Epicguru/Midship-Runabout-Rusefi-PNP-KiCAD/Original Source/Readme.md

These are the original Gerber, BOM and CPL files that were used to make the KiCAD version.
Also included is the original tune.
These will not be updated even if the upstream is updated - they are just for reference.

My version of the board has a slightly different pinout, it has extra inputs as well, so the tune is different.
