Epicguru/Midship-Runabout-Rusefi-PNP-KiCAD/Original Source/MRRpinout.png

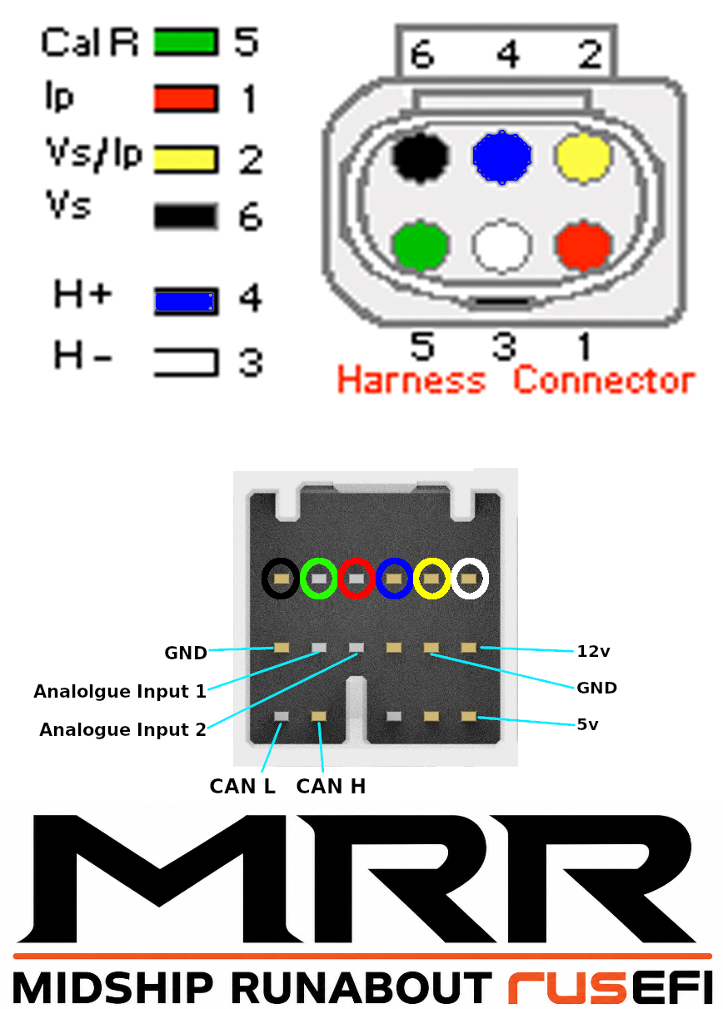
Original Source/MRRpinout.png
