Epicguru/Midship-Runabout-Rusefi-PNP-KiCAD/Original Source/Schematic_PnP-ECU2-Rev2_2026-10-17.png

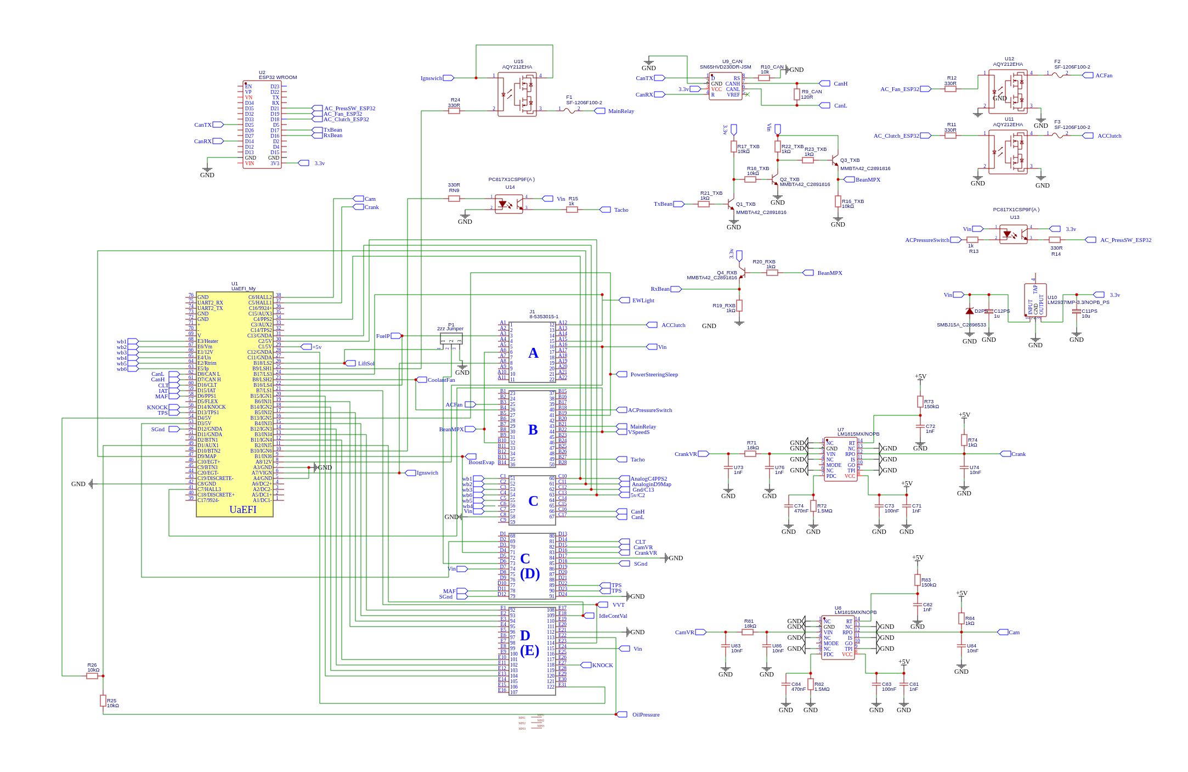
Original Source/Schematic_PnP-ECU2-Rev2_2026-10-17.png
