Epicguru/Midship-Runabout-Rusefi-PNP-KiCAD/KiCAD Source/MRR_PnP_ECU2.kicad_pcb

## KiCad design KiCAD Source/MRR_PnP_ECU2.kicad_pcb (2026-10-23)

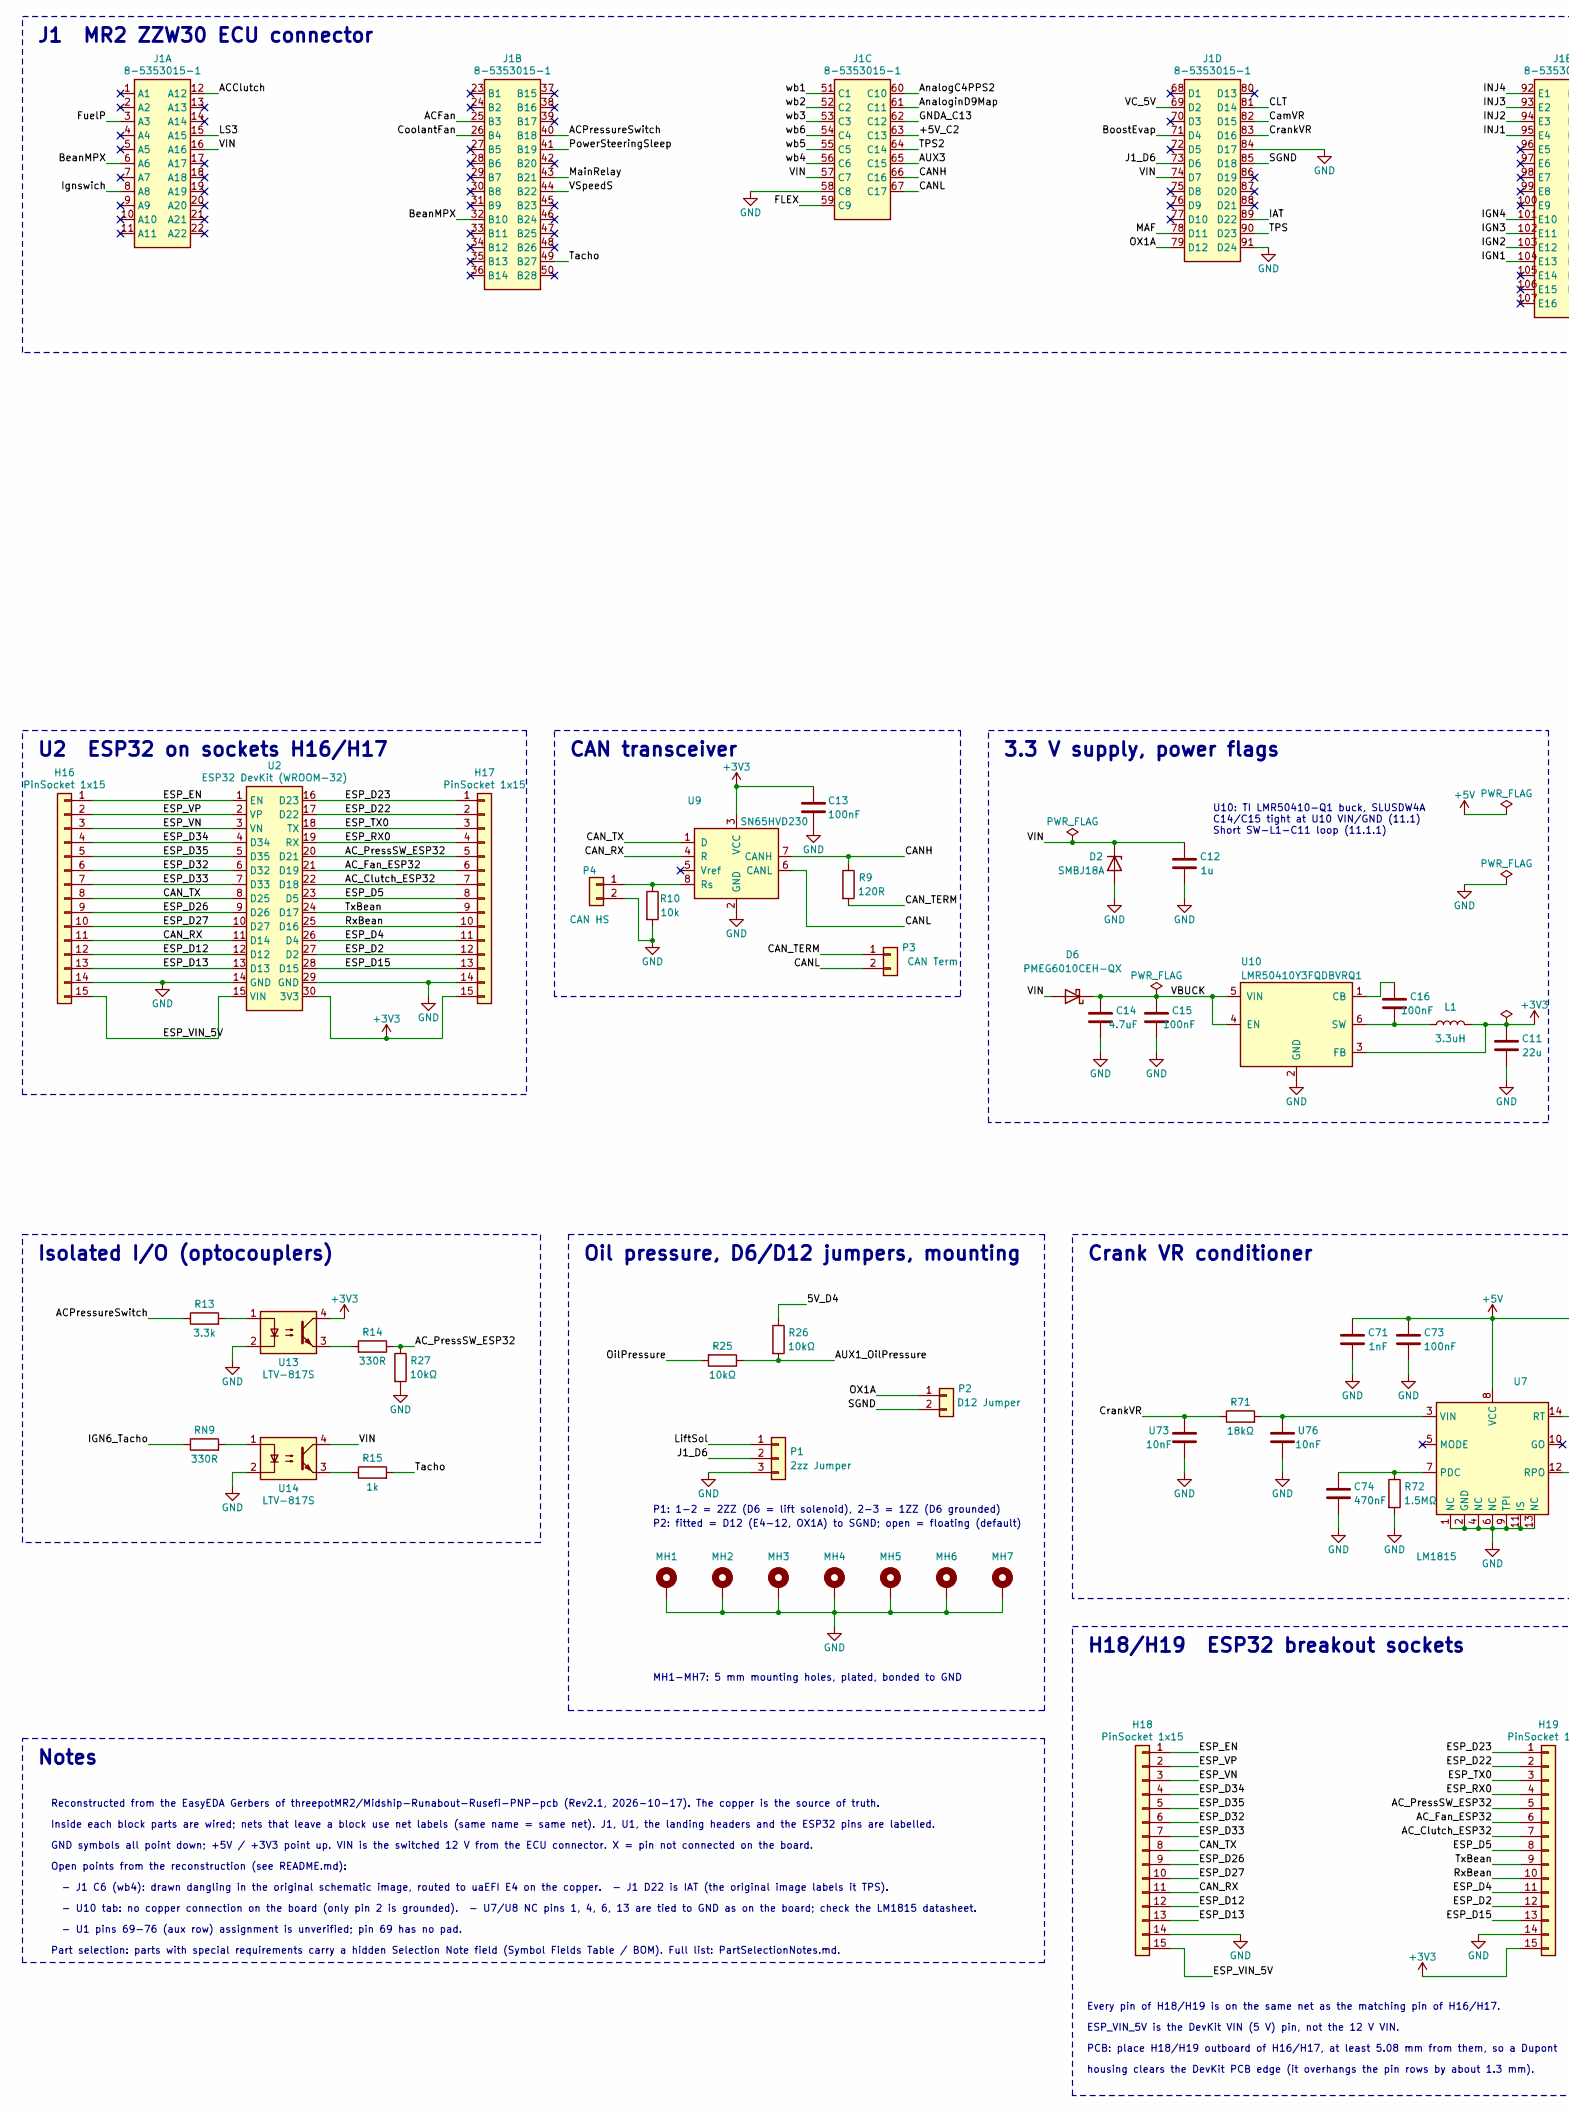
[picture p11: schematic MRR_PnP_ECU2.kicad_sch, MRR PnP-ECU2 Rev2.1 - uaEFI carrier, MR2 ZZW30, part in row 1, column 1]

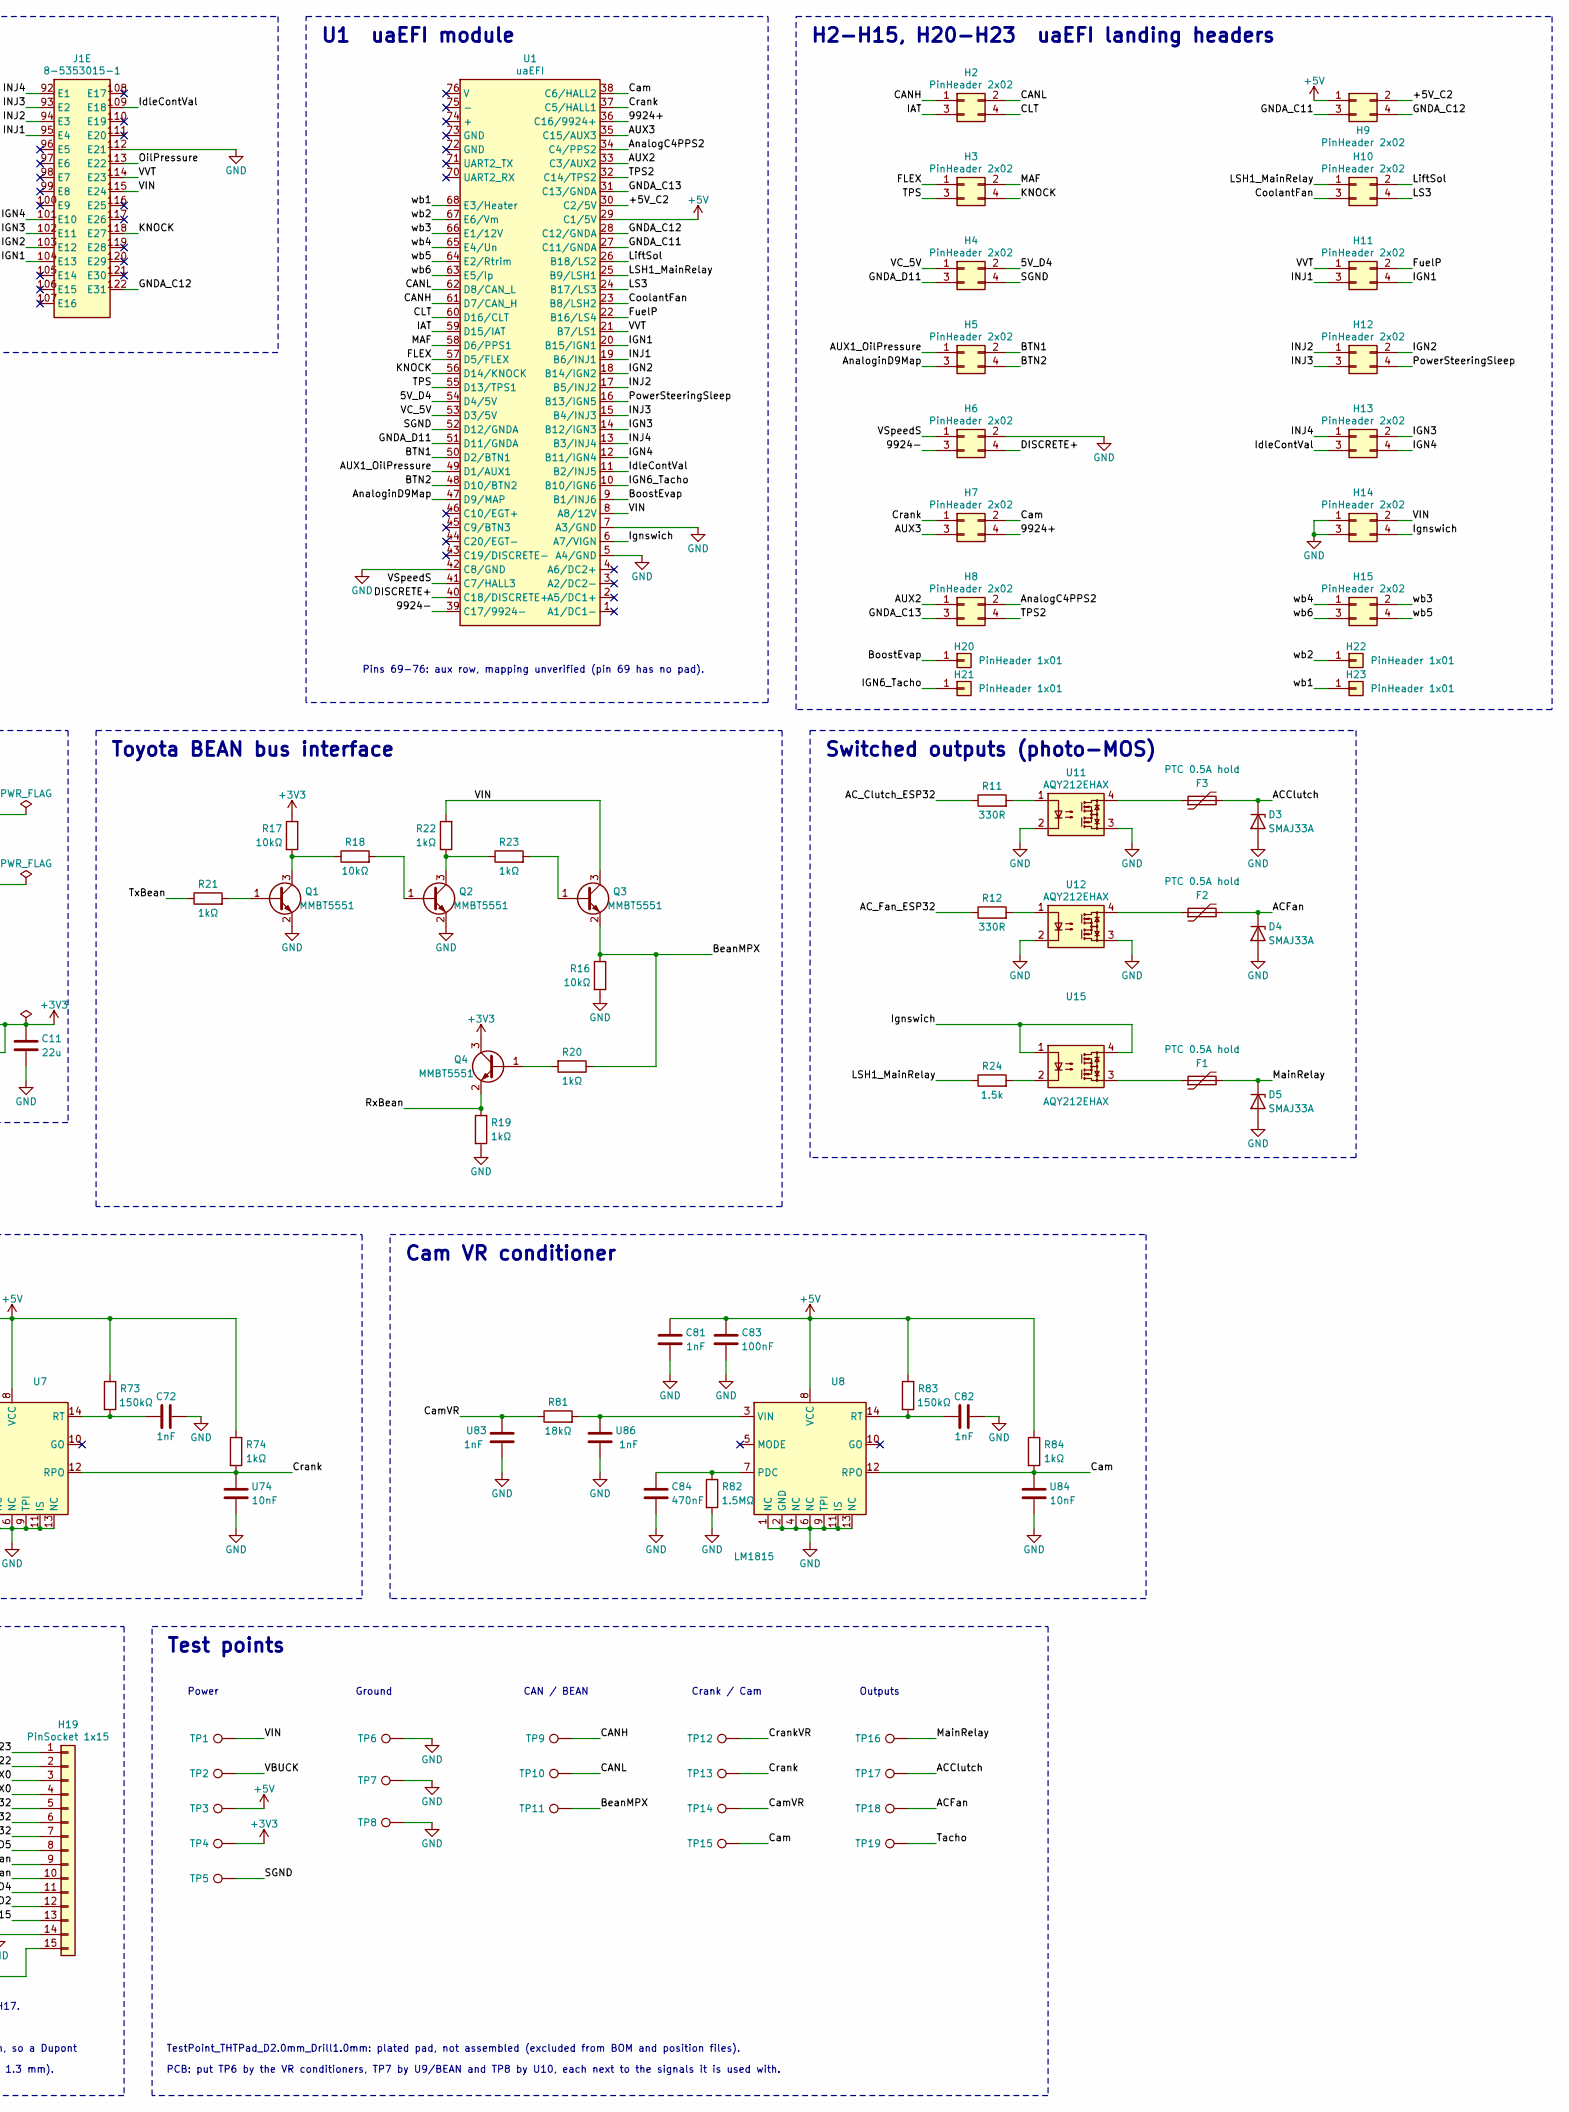
[picture p12: schematic MRR_PnP_ECU2.kicad_sch, MRR PnP-ECU2 Rev2.1 - uaEFI carrier, MR2 ZZW30, part in row 1, column 2]

Parts:
C11: 22u; C_1206_3216Metric; MPN CL31A226KAHNNNE; LCSC C12891
C12: 1u; C_0603_1608Metric; MPN CL10B105KB8NQNC; LCSC C5199872
C13, C15, C16, C73, C83: 100nF; C_0603_1608Metric; MPN CC0603KRX7R9BB104; LCSC C14663
C14: 4.7uF; C_0805_2012Metric; MPN GRM21BZ71H475KE15L; LCSC C437557
C71, C81: 1nF; C_0603_1608Metric; MPN CL10B102KB8NNNC; LCSC C1588
C72, C82: 1nF; C_0603_1608Metric; MPN GCM1885C2A102JA16D; LCSC C437457
C74, C84: 470nF; C_0603_1608Metric; MPN CL10B474KA8NNNC; LCSC C1623
D2: SMBJ18A; D_SMB; MPN SMBJ18AQ; LCSC C5861908
D3, D4, D5: SMAJ33A; D_SMA; MPN SMAJ33A; LCSC C41376399
D6: PMEG6010CEH-QX; D_SOD-123F; MPN PMEG6010CEH-QX; LCSC C5311567
F1, F2, F3: PTC 0.5A hold; Fuse_1206_3216Metric; MPN JK-nSMD050-30; LCSC C720075
H2, H3, H4, H5, H6, H7, H8, H9, H10, H11, H12, H13, H14, H15: PinHeader 2x02; PinHeader_2x02_P2.54mm_uaEFI; MPN 2.54-2*2PPin; LCSC C66690
H16, H17, H18, H19: PinSocket 1x15; PinSocket_1x15_P2.54mm_Vertical; MPN B-2200S15P-A120; LCSC C124408
H20, H21, H22, H23: PinHeader 1x01; PinHeader_1x01_P2.54mm_uaEFI; MPN 2.54-1*1PPin; LCSC C81276
J1: 8-5353015-1; Toyota_ZZW30_ECU_122pin_MRR
L1: 3.3uH; L_Sunlord_SWPA4030S; MPN SWPA4030S3R3MT; LCSC C15269
MH1, MH2, MH3, MH4, MH5, MH6, MH7: MountingHole 5mm; MountingHole_5mm_Pad_7mm
P1: 2zz Jumper; PinHeader_1x03_P2.54mm_Vertical; MPN PZ254V-11-03P; LCSC C2937625
P2: D12 Jumper; PinHeader_1x02_P2.54mm_Vertical; MPN PZ254V-11-02P; LCSC C492401
P3: CAN Term; PinHeader_1x02_P2.54mm_Vertical; MPN PZ254V-11-02P; LCSC C492401
P4: CAN HS; PinHeader_1x02_P2.54mm_Vertical; MPN PZ254V-11-02P; LCSC C492401
Q1, Q2, Q3, Q4: MMBT5551; SOT-23; MPN MMBT5551(RANGE:200-300); LCSC C2145
R9: 120R; R_0603_1608Metric; MPN 0603WAF1200T5E; LCSC C22787
R10: 10k; R_0603_1608Metric; MPN 0603WAF1002T5E; LCSC C25804
R11, R12, R14: 330R; R_0603_1608Metric; MPN 0603WAF3300T5E; LCSC C23138
R13: 3.3k; R_0603_1608Metric; MPN 0603WAF3301T5E; LCSC C22978
R15: 1k; R_0603_1608Metric; MPN ESR03EZPF1001; LCSC C2653986
R16, R17, R18, R25, R26, R27: 10kΩ; R_0603_1608Metric; MPN 0603WAF1002T5E; LCSC C25804
R19, R20, R21, R23, R74, R84: 1kΩ; R_0603_1608Metric; MPN 0603WAF1001T5E; LCSC C21190
R22: 1kΩ; R_1210_3225Metric; MPN 1210W2F1001T5E; LCSC C52444
R24: 1.5k; R_1206_3216Metric; MPN 1206W4F1501T5E; LCSC C26030
R71, R81: 18kΩ; R_1210_3225Metric; MPN 1210W2F1802T5E; LCSC C67557
R72, R82: 1.5MΩ; R_0603_1608Metric; MPN 0603WAF1504T5E; LCSC C4172
R73, R83: 150kΩ; R_0603_1608Metric; MPN 0603WAF1503T5E; LCSC C22807
RN9: 330R; R_0603_1608Metric; MPN 0603WAF3300T5E; LCSC C23138
TP1: VIN; TestPoint_THTPad_D2.0mm_Drill1.0mm
TP2: VBUCK; TestPoint_THTPad_D2.0mm_Drill1.0mm
TP3: +5V; TestPoint_THTPad_D2.0mm_Drill1.0mm
TP4: +3V3; TestPoint_THTPad_D2.0mm_Drill1.0mm
TP5: SGND; TestPoint_THTPad_D2.0mm_Drill1.0mm
TP6, TP7, TP8: GND; TestPoint_THTPad_D2.0mm_Drill1.0mm
TP9: CANH; TestPoint_THTPad_D2.0mm_Drill1.0mm
TP10: CANL; TestPoint_THTPad_D2.0mm_Drill1.0mm
TP11: BeanMPX; TestPoint_THTPad_D2.0mm_Drill1.0mm
TP12: CrankVR; TestPoint_THTPad_D2.0mm_Drill1.0mm
TP13: Crank; TestPoint_THTPad_D2.0mm_Drill1.0mm
TP14: CamVR; TestPoint_THTPad_D2.0mm_Drill1.0mm
TP15: Cam; TestPoint_THTPad_D2.0mm_Drill1.0mm
TP16: MainRelay; TestPoint_THTPad_D2.0mm_Drill1.0mm
TP17: ACClutch; TestPoint_THTPad_D2.0mm_Drill1.0mm
TP18: ACFan; TestPoint_THTPad_D2.0mm_Drill1.0mm
TP19: Tacho; TestPoint_THTPad_D2.0mm_Drill1.0mm
U1: uaEFI; uaEFI_Carrier_MRR
U2: ESP32 DevKit (WROOM-32); ESP32_DevKit_30pin_MRR; MPN ESP32 WROOM-32 ESP32-S
U7, U8: LM1815; SOIC-14_3.9x8.7mm_P1.27mm; MPN LM1815MX/NOPB; LCSC C2878578
U9: SN65HVD230; SOIC-8_3.9x4.9mm_P1.27mm; MPN SN65HVD230DR; LCSC C12084
U10: LMR50410Y3FQDBVRQ1; SOT-23-6; MPN LMR50410Y3FQDBVRQ1; LCSC C5219374
U11, U12, U15: AQY212EHAX; SMDIP-4_W9.53mm; MPN AQY212EHAX; LCSC C29276
U13, U14: LTV-817S; SMDIP-4_W9.53mm; MPN LTV-817S-TA1-C; LCSC C109227
U73: 10nF; C_0603_1608Metric; MPN CC0603KRX7R0BB103; LCSC C107059
U74, U76, U84: 10nF; C_0603_1608Metric; MPN 0603B103K500NT; LCSC C57112
U83, U86: 1nF; C_0603_1608Metric; MPN GCM1885C2A102JA16D; LCSC C437457

Connections:
+3V3: C11.2, C13.1, H17.15, H19.15, L1.2, Q4.3 (C), R17.1, TP4.1 (1_1), U2.30 (3V3), U9.3 (VCC), U10.3 (FB), U13.4
+5V: C71.1, C73.1, C81.1, C83.1, H9.1, R73.1, R74.1, R83.1, R84.1, TP3.1 (1_1), U1.29 (C1/5V), U7.8 (VCC), U8.8 (VCC)
/5V_D4: H4.2, R26.1, U1.54 (D4/5V)
/9924+: H7.4, U1.36 (C16/9924+)
/9924-: H6.3, U1.39 (C17/9924-)
/+5V_C2: H9.2, J1.63 (C13), U1.30 (C2/5V)
/ACClutch: D3.1 (K), F3.2, J1.12 (A12), TP17.1 (1_1)
/ACFan: D4.1 (K), F2.2, J1.25 (B3), TP18.1 (1_1)
/ACPressureSwitch: J1.40 (B18), R13.1
/AC_Clutch_ESP32: H17.7, H19.7, R11.1, U2.22 (D18)
/AC_Fan_ESP32: H17.6, H19.6, R12.1, U2.21 (D19)
/AC_PressSW_ESP32: H17.5, H19.5, R14.1, R27.1, U2.20 (D21)
/AUX1_OilPressure: H5.1, R25.1, R26.2, U1.49 (D1/AUX1)
/AUX2: H8.1, U1.33 (C3/AUX2)
/AUX3: H7.3, J1.65 (C15), U1.35 (C15/AUX3)
/AnalogC4PPS2: H8.2, J1.60 (C10), U1.34 (C4/PPS2)
/AnaloginD9Map: H5.3, J1.61 (C11), U1.47 (D9/MAP)
/BTN1: H5.2, U1.50 (D2/BTN1)
/BTN2: H5.4, U1.48 (D10/BTN2)
/BeanMPX: J1.6 (A6), J1.32 (B10), Q3.2 (E), R16.1, R20.1, TP11.1 (1_1)
/BoostEvap: H20.1, J1.71 (D4), U1.9 (B1/INJ6)
/CANH: H2.1, J1.66 (C16), R9.1, TP9.1 (1_1), U1.61 (D7/CAN_H), U9.7 (CANH)
/CANL: H2.2, J1.67 (C17), P3.2, TP10.1 (1_1), U1.62 (D8/CAN_L), U9.6 (CANL)
/CAN_RX: H16.11, H18.11, U2.11 (D14), U9.4 (R)
/CAN_TERM: P3.1, R9.2
/CAN_TX: H16.8, H18.8, U2.8 (D25), U9.1 (D)
/CLT: H2.4, J1.81 (D14), U1.60 (D16/CLT)
/Cam: H7.2, R84.2, TP15.1 (1_1), U1.38 (C6/HALL2), U8.12 (RPO), U84.1
/CamVR: J1.82 (D15), R81.1, TP14.1 (1_1), U83.1
/CoolantFan: H10.3, J1.26 (B4), U1.23 (B8/LSH2)
/Crank: H7.1, R74.2, TP13.1 (1_1), U1.37 (C5/HALL1), U7.12 (RPO), U74.1
/CrankVR: J1.83 (D16), R71.1, TP12.1 (1_1), U73.1
/DISCRETE+: H6.4, U1.40 (C18/DISCRETE+)
/ESP_D2: H17.12, H19.12, U2.27 (D2)
/ESP_D4: H17.11, H19.11, U2.26 (D4)
/ESP_D5: H17.8, H19.8, U2.23 (D5)
/ESP_D12: H16.12, H18.12, U2.12 (D12)
/ESP_D13: H16.13, H18.13, U2.13 (D13)
/ESP_D15: H17.13, H19.13, U2.28 (D15)
/ESP_D22: H17.2, H19.2, U2.17 (D22)
/ESP_D23: H17.1, H19.1, U2.16 (D23)
/ESP_D26: H16.9, H18.9, U2.9 (D26)
/ESP_D27: H16.10, H18.10, U2.10 (D27)
/ESP_D32: H16.6, H18.6, U2.6 (D32)
/ESP_D33: H16.7, H18.7, U2.7 (D33)
/ESP_D34: H16.4, H18.4, U2.4 (D34)
/ESP_D35: H16.5, H18.5, U2.5 (D35)
/ESP_EN: H16.1, H18.1, U2.1 (EN)
/ESP_RX0: H17.4, H19.4, U2.19 (RX)
/ESP_TX0: H17.3, H19.3, U2.18 (TX)
/ESP_VIN_5V: H16.15, H18.15, U2.15 (VIN)
/ESP_VN: H16.3, H18.3, U2.3 (VN)
/ESP_VP: H16.2, H18.2, U2.2 (VP)
/FLEX: H3.1, J1.59 (C9), U1.57 (D5/FLEX)
/FuelP: H11.2, J1.3 (A3), U1.22 (B16/LS4)
/GNDA_C11: H9.3, U1.27 (C11/GNDA)
/GNDA_C12: H9.4, J1.122 (E31), U1.28 (C12/GNDA)
/GNDA_C13: H8.3, J1.62 (C12), U1.31 (C13/GNDA)
/GNDA_D11: H4.3, U1.51 (D11/GNDA)
/IAT: H2.3, J1.89 (D22), U1.59 (D15/IAT)
/IGN1: H11.4, J1.104 (E13), U1.20 (B15/IGN1)
/IGN2: H12.2, J1.103 (E12), U1.18 (B14/IGN2)
/IGN3: H13.2, J1.102 (E11), U1.14 (B12/IGN3)
/IGN4: H13.4, J1.101 (E10), U1.12 (B11/IGN4)
/IGN6_Tacho: H21.1, RN9.1, U1.10 (B10/IGN6)
/INJ1: H11.3, J1.95 (E4), U1.19 (B6/INJ1)
/INJ2: H12.1, J1.94 (E3), U1.17 (B5/INJ2)
/INJ3: H12.3, J1.93 (E2), U1.15 (B4/INJ3)
/INJ4: H13.1, J1.92 (E1), U1.13 (B3/INJ4)
/IdleContVal: H13.3, J1.109 (E18), U1.11 (B2/INJ5)
/Ignswich: H14.4, J1.8 (A8), U1.6 (A7/VIGN), U15.1, U15.4
/J1_D6: J1.73 (D6), P1.2
/KNOCK: H3.4, J1.118 (E27), U1.56 (D14/KNOCK)
/LS3: H10.4, J1.15 (A15), U1.24 (B17/LS3)
/LSH1_MainRelay: H10.1, R24.1, U1.25 (B9/LSH1)
/LiftSol: H10.2, P1.1, U1.26 (B18/LS2)
/MAF: H3.2, J1.78 (D11), U1.58 (D6/PPS1)
/MainRelay: D5.1 (K), F1.2, J1.43 (B21), TP16.1 (1_1)
/OX1A: J1.79 (D12), P2.1
/OilPressure: J1.113 (E22), R25.2
/PowerSteeringSleep: H12.4, J1.41 (B19), U1.16 (B13/IGN5)
/RxBean: H17.10, H19.10, Q4.2 (E), R19.1, U2.25 (D16)
/SGND: H4.4, J1.85 (D18), P2.2, TP5.1 (1_1), U1.52 (D12/GNDA)
/TPS: H3.3, J1.90 (D23), U1.55 (D13/TPS1)
/TPS2: H8.4, J1.64 (C14), U1.32 (C14/TPS2)
/Tacho: J1.49 (B27), R15.2, TP19.1 (1_1)
/TxBean: H17.9, H19.9, R21.1, U2.24 (D17)
/VBUCK: C14.2, C15.2, D6.1 (K), TP2.1 (1_1), U10.4 (EN), U10.5 (VIN)
/VC_5V: H4.1, J1.69 (D2), U1.53 (D3/5V)
/VIN: C12.2, D2.1 (K), D6.2 (A), H14.2, J1.16 (A16), J1.57 (C7), J1.74 (D7), J1.115 (E24), Q3.3 (C), R22.2, TP1.1 (1_1), U1.8 (A8/12V), U14.4
/VSpeedS: H6.1, J1.44 (B22), U1.41 (C7/HALL3)
/VVT: H11.1, J1.114 (E23), U1.21 (B7/LS1)
/wb1: H23.1, J1.51 (C1), U1.68 (E3/Heater)
/wb2: H22.1, J1.52 (C2), U1.67 (E6/Vm)
/wb3: H15.2, J1.53 (C3), U1.66 (E1/12V)
/wb4: H15.1, J1.56 (C6), U1.65 (E4/Un)
/wb5: H15.4, J1.55 (C5), U1.64 (E2/Rtrim)
/wb6: H15.3, J1.54 (C4), U1.63 (E5/Ip)
GND: C11.1, C12.1, C13.2, C14.1, C15.1, C71.2, C72.2, C73.2, C74.1, C81.2, C82.2, C83.2, C84.1, D2.2 (A), D3.2 (A), D4.2 (A), D5.2 (A), H6.2, H14.1, H14.3, H16.14, H17.14, H18.14, H19.14, J1.58 (C8), J1.84 (D17), J1.91 (D24), J1.112 (E21), MH1.1 (1_1), MH2.1 (1_1), MH3.1 (1_1), MH4.1 (1_1), MH5.1 (1_1), MH6.1 (1_1), MH7.1 (1_1), P1.3, P4.2, Q1.2 (E), Q2.2 (E), R10.2, R16.2, R19.2, R27.2, R72.2, R82.2, TP6.1 (1_1), TP7.1 (1_1), TP8.1 (1_1), U1.5 (A4/GND), U1.7 (A3/GND), U1.42 (C8/GND), U2.14 (GND), U2.29 (GND), U7.1 (NC), U7.2 (GND), U7.4 (NC), U7.6 (NC), U7.9 (TPI), U7.11 (IS), U7.13 (NC), U8.1 (NC), U8.2 (GND), U8.4 (NC), U8.6 (NC), U8.9 (TPI), U8.11 (IS), U8.13 (NC), U9.2 (GND), U10.2 (GND), U11.2, U11.3, U12.2, U12.3, U13.2, U14.2, U73.2, U74.2, U76.2, U83.2, U84.2, U86.2
unnamed: F1.1, U15.3
unnamed: F2.1, U12.4
unnamed: F3.1, U11.4
unnamed: P4.1, R10.1, U9.8 (Rs)
unnamed: Q1.1 (B), R21.2
unnamed: Q1.3 (C), R17.2, R18.1
unnamed: Q2.1 (B), R18.2
unnamed: Q2.3 (C), R22.1, R23.1
unnamed: Q3.1 (B), R23.2
unnamed: Q4.1 (B), R20.2
unnamed: R11.2, U11.1
unnamed: R12.2, U12.1
unnamed: R13.2, U13.1
unnamed: R14.2, U13.3
unnamed: R15.1, U14.3
unnamed: R24.2, U15.2
unnamed: RN9.2, U14.1
unnamed: C74.2, R72.1, U7.7 (PDC)
unnamed: C72.1, R73.2, U7.14 (RT)
unnamed: R71.2, U7.3 (VIN), U76.1
unnamed: C84.2, R82.1, U8.7 (PDC)
unnamed: C82.1, R83.2, U8.14 (RT)
unnamed: R81.2, U8.3 (VIN), U86.1
unnamed: C16.2, U10.1 (CB)
unnamed: C16.1, L1.1, U10.6 (SW)

Notes on the sheet:
3.3 V supply, power flags
- J1 C6 (wb4): drawn dangling in the original schematic image, routed to uaEFI E4 on the copper. - J1 D22 is IAT (the original image labels it TPS).
Reconstructed from the EasyEDA Gerbers of threepotMR2/Midship-Runabout-Rusefi-PNP-pcb (Rev2.1, 2026-10-17). The copper is the source of truth.
P2: fitted = D12 (E4-12, OX1A) to SGND; open = floating (default)
housing clears the DevKit PCB edge (it overhangs the pin rows by about 1.3 mm).
Ground
TestPoint_THTPad_D2.0mm_Drill1.0mm: plated pad, not assembled (excluded from BOM and position files).
Crank / Cam
Toyota BEAN bus interface
Notes
- U1 pins 69-76 (aux row) assignment is unverified; pin 69 has no pad.
Isolated I/O (optocouplers)
Switched outputs (photo-MOS)
CAN / BEAN
Every pin of H18/H19 is on the same net as the matching pin of H16/H17.
U1 uaEFI module
MH1-MH7: 5 mm mounting holes, plated, bonded to GND
Cam VR conditioner
P1: 1-2 = 2ZZ (D6 = lift solenoid), 2-3 = 1ZZ (D6 grounded)
Open points from the reconstruction (see README.md):
PCB: put TP6 by the VR conditioners, TP7 by U9/BEAN and TP8 by U10, each next to the signals it is used with.
U10: TI LMR50410-Q1 buck, SLUSDW4A C14/C15 tight at U10 VIN/GND (11.1) Short SW-L1-C11 loop (11.1.1)
Test points
Power
Oil pressure, D6/D12 jumpers, mounting
Outputs
U2 ESP32 on sockets H16/H17
J1 MR2 ZZW30 ECU connector
CAN transceiver
Pins 69-76: aux row, mapping unverified (pin 69 has no pad).
Inside each block parts are wired; nets that leave a block use net labels (same name = same net). J1, U1, the landing headers and the ESP32 pins are labelled.
- U10 tab: no copper connection on the board (only pin 2 is grounded). - U7/U8 NC pins 1, 4, 6, 13 are tied to GND as on the board; check the LM1815 datasheet.
Part selection: parts with special requirements carry a hidden Selection Note field (Symbol Fields Table / BOM). Full list: PartSelectionNotes.md.
H18/H19 ESP32 breakout sockets
GND symbols all point down; +5V / +3V3 point up. VIN is the switched 12 V from the ECU connector. X = pin not connected on the board.
H2-H15, H20-H23 uaEFI landing headers
PCB: place H18/H19 outboard of H16/H17, at least 5.08 mm from them, so a Dupont
Crank VR conditioner
ESP_VIN_5V is the DevKit VIN (5 V) pin, not the 12 V VIN.

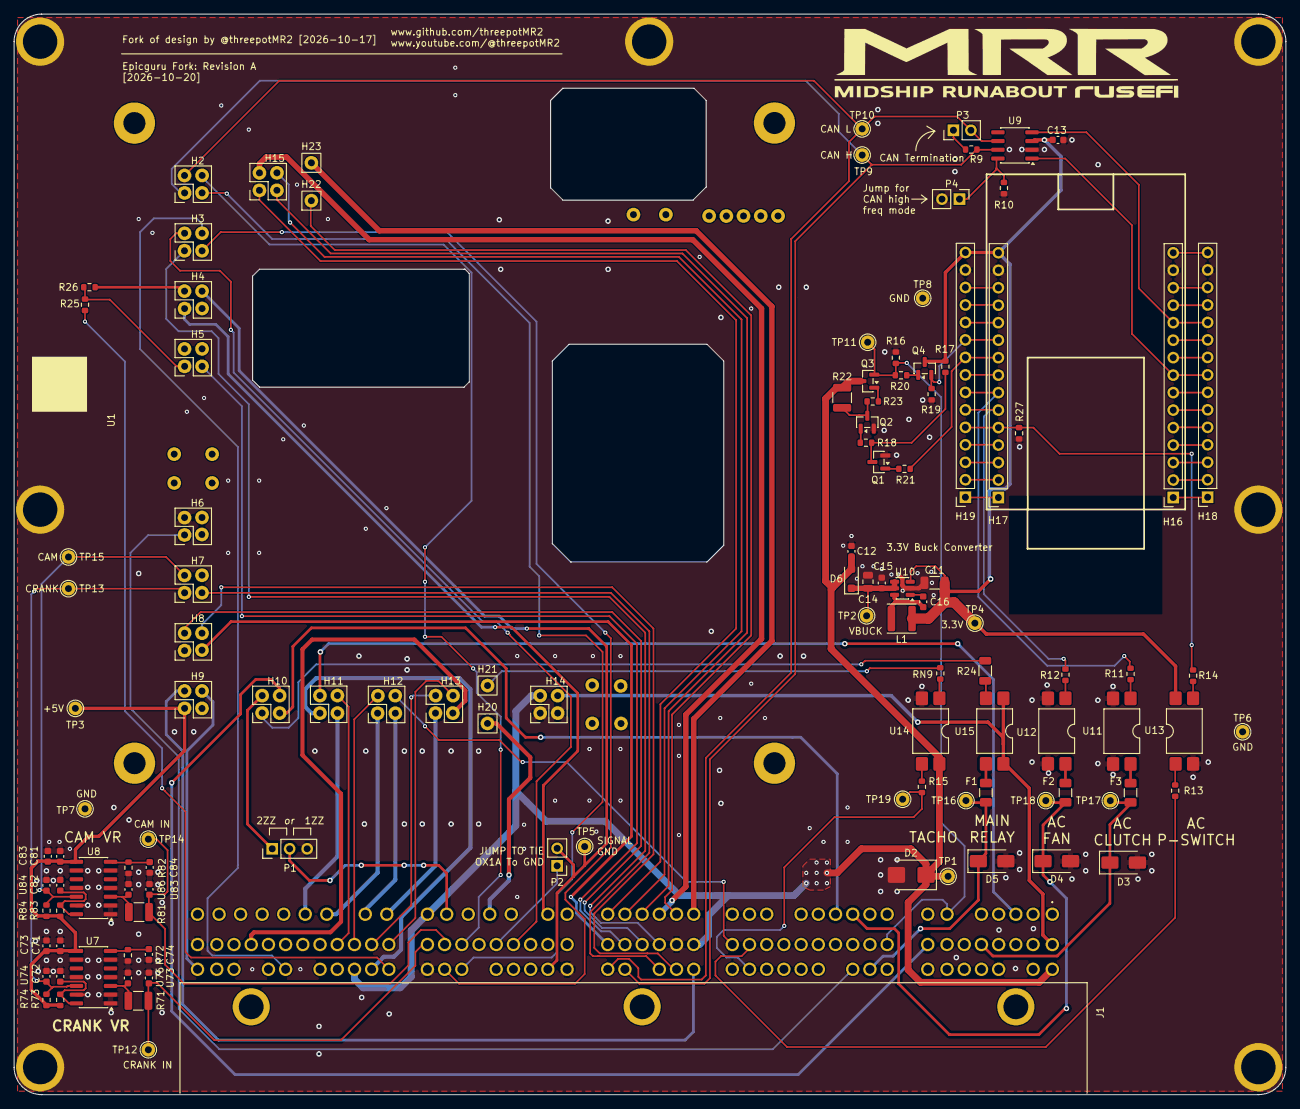
[picture p13: board MRR_PnP_ECU2.kicad_pcb from above]

Board: 4 copper layers, 184.8 x 157.0 mm, 124 parts (0 on the bottom side), 124 nets.
