Epicguru/Midship-Runabout-Rusefi-PNP-KiCAD/(commit log)

2026-10-21 Add KiCAD files, re-organize original files.
2026-10-23 Add 3D models to connectors, uaEFI, ESP32.
